SimonSchaeff/variable-frequency-drive-induction-motor/source_code/README.md

# README for Source Code

Create an empty folder for workspace of STM32 IDE
(It is not the project folder!)
