SimonSchaeff/variable-frequency-drive-induction-motor/hardware/BOM/BOM_Frequenzumrchter_Hoyer_Schaeffler_Scheel.xlsx

No. | Schaltplanbauteil | Bezeichnung | Wert | Footprint | Menge
1 | C1, C3, C7, C9, C20, C21, C23, C28, C34 |  | 100nF | C_0603_1608Metric | 9
2 | C15, C16, C17, C18, C19, C22, C24, C26 |  | 10nF | C_0603_1608Metric | 8
3 | C27, C29, C30, C31, C32, C33 |  | 220pF | C_0603_1608Metric | 6
4 | C10, C11, C12, C13, C14 | Elektrolytkondensator | LGU2W471MELC | CAPPRD1000W190D3550H5200 | 5
5 | C2, C4, C6, C8 |  | 10uF | C_1206_3216Metric | 4
6 | C5, C25 |  | 4.7 nF | C_0603_1608Metric | 2
7 | C35 |  | 330nF | C_0603_1608Metric | 1
8 | C36 |  | 1uF | C_0603_1608Metric | 1
9 | R1, R2, R3, R5, R6, R7, R8, R9, R10, R11 |  | 1k | R_0603_1608Metric | 10
10 | R28, R30, R31, R32, R35, R36, R37 |  | 100 | R_0603_1608Metric | 7
11 | R38, R39, R40, R41, R42, R43, R44 |  | 150 | R_0603_1608Metric | 7
12 | R14, R15, R16 | Shunt-Widerstand | WSLF25123L000FEA | RESC6430X48N | 3
13 | R17, R18, R19 |  | 3.9k | R_0603_1608Metric | 3
14 | R20, R22, R24 |  | 15k | R_0603_1608Metric | 3
15 | R21, R23, R25 |  | 12k | R_0603_1608Metric | 3
16 | R29, R33 |  | 10k | R_0603_1608Metric | 2
17 | R4 |  | 1 | R_0603_1608Metric | 1
18 | R12 | Leistungswiderstand 5W | EP5WS47RJ | RESAD5900W80L2500D850 | 1
19 | R13 |  | R 100k | R_0603_1608Metric | 1
20 | R26 |  | R 33k | R_0603_1608Metric | 1
21 | R27 |  | R 100 | R_0603_1608Metric | 1
22 | R34 |  | 470 | R_0603_1608Metric | 1
23 | D1, D2, D4, D5 | Gleichrichterdiode | 10A10-T | DIOAD4425W130L885D885 | 4
24 | D3 | Schutzdiode | 1N4007 | D_DO-41_SOD81_P10.16mm_Horizontal | 1
25 | D6 |  | LED | LED_0805_2012Metric | 1
26 | U1, U2, U3 | Strommess-IC | INA240A3D | SOIC-8_3.9x4.9mm_P1.27mm | 3
27 | U4 | 12V Spannungsregler | MC78M12BDTRKG | DPAK-3_ONS | 1
28 | DS1, DS2 | 7-Seg. Display | SC52-11SURKWA | SC5211SURKWA | 2
29 | IC1 | Powermodul | IM523L6AXKMA1 | IM523L6AXKMA1 | 1
30 | K1 | Vorladerelais | T9GV5L14-15 | T9GV5L1415 | 1
31 | PS1 | 15V Netzteil | IRM-10-15 | Converter_ACDC_MeanWell_IRM-10-xx_THT | 1
32 | Q1 | Bipolartransistor: | BC337 | TO-92_Inline | 1
33 | RV1 | Potentiometer | PC16SV-10IP06-103A2020-TA_PHR | PC16SV-10IP06-103A2020-TA_PHR | 1
34 | S1 | Button-Switch | TL1105YF160Q | TL1105YF160Q | 1
35 | Z1 | Zehnerdiode | 1N5352B-TP | DIOAD1910W90L670D310 | 1
36 | J1, J4 | Anschlussklemme | WAGO 2604-1103 | 26041103 | 2
37 | J7, J8 | Pinsockel | Pin Socket 61304021821 | RHDR40W97P254X254_2X20_5130X508X860P | 2
38 | J2 | Pinsockel | Conn_01x06_Socket | PinSocket_1x06_P2.54mm_Vertical | 1
39 | J3 | Banannebuchse rot | 66.9040-22 | 66904022 | 1
40 | J5 | Banannebuchse schwarz | 66.9040-21 | 66904021 | 1
41 | J6 | Lüfterstecker: | MC000034 | MC000034 | 1
42 |  | Kühlkörper | Fischer SK 68 100 SA | n/a | 1
43 |  | Lüfter | MF50101V1-1000U-G99 | n/a | 1
44 |  | Prozessor STM32 mit Eval platine | NUCLEO F103RB | n/a | 1
