SimonSchaeff/variable-frequency-drive-induction-motor/hardware/production/bom.csv

Designator | Footprint | Quantity | Value | LCSC Part #
C1, C20, C21, C23, C28, C3, C34, C7, C9 | 0603 | 9 | 100nF
C10, C11, C12, C13, C14 | CAPPRD1000W190D3550H5200 | 5 | LGU2W471MELC
C15, C16, C17, C18, C19, C22, C24, C26 | 0603 | 8 | 10nF
C2, C4, C6, C8 | 1206 | 4 | 10uF
C25 | 0603 | 1 | C 1nF
C27, C29, C30, C31, C32, C33 | 0603 | 6 | 220pF
C35 | 0603 | 1 | 330nF
C36 | 0603 | 1 | 1uF
C5 | 0603 | 1 | 4.7 nF
D1, D2, D4, D5 | DIOAD4425W130L885D885 | 4 | 10A10-T
D3 | D_DO-41_SOD81_P10.16mm_Horizontal | 1 | 1N4007
D6 | 0805 | 1 | LED
DS1, DS2 | SC5211SURKWA | 2 | SC52-11SURKWA
IC1 | IM523L6AXKMA1 | 1 | IM523L6AXKMA1
J1, J4 | 26041103 | 2 | 2604-1103
J2 | PinSocket_1x06_P2.54mm_Vertical | 1 | Conn_01x06_Socket
J3 | 66904022 | 1 | 66.9040-22
J5 | 66904021 | 1 | 66.9040-21
J6 | MC000034 | 1 | MC000034
J7, J8 | RHDR40W97P254X254_2X20_5130X508X860P | 2 | 61304021821
K1 | T9GV5L1415 | 1 | T9GV5L14-15
PS1 | Converter_ACDC_MeanWell_IRM-10-xx_THT | 1 | IRM-10-15
Q1 | TO-92_Inline | 1 | BC337
R10, R5, R6, R7, R8, R9 | 0603 | 6 | 1k
R11 | 0603 | 1 | R 1k
R12 | RESAD5900W80L2500D850 | 1 | EP5WS47RJ
R13 | 0603 | 1 | R 100k
R14, R15, R16 | RESC6430X48N | 3 | WSLF25123L000FEA
R17, R18, R19 | 0603 | 3 | 3.9k
R20, R22, R24 | 0603 | 3 | R 15k
R21, R23, R25 | 0603 | 3 | R 12k
R26 | 0603 | 1 | R 33k
R27 | 0603 | 1 | R 100
R28, R30, R31, R32, R35 | 0603 | 5 | 100
R29, R33 | 0603 | 2 | 10k
R34 | 0603 | 1 | 470R
R36, R37 | 0603 | 2 | 100R
R38, R39, R40, R41, R42, R43, R44 | 0603 | 7 | 150
RV1 | PC16SV-10IP06-103A2020-TA_PHR | 1 | 5k
S1 | TL1105YF160Q | 1 | TL1105YF160Q
U1, U2, U3 | SOIC-8_3.9x4.9mm_P1.27mm | 3 | INA240A3D
U4 | DPAK-3_ONS | 1 | MC78M12BDTRKG
Z1 | DIOAD1910W90L670D310 | 1 | 1N5352B-TP
