SimonSchaeff/variable-frequency-drive-induction-motor/hardware/3dmodel/VFD.step

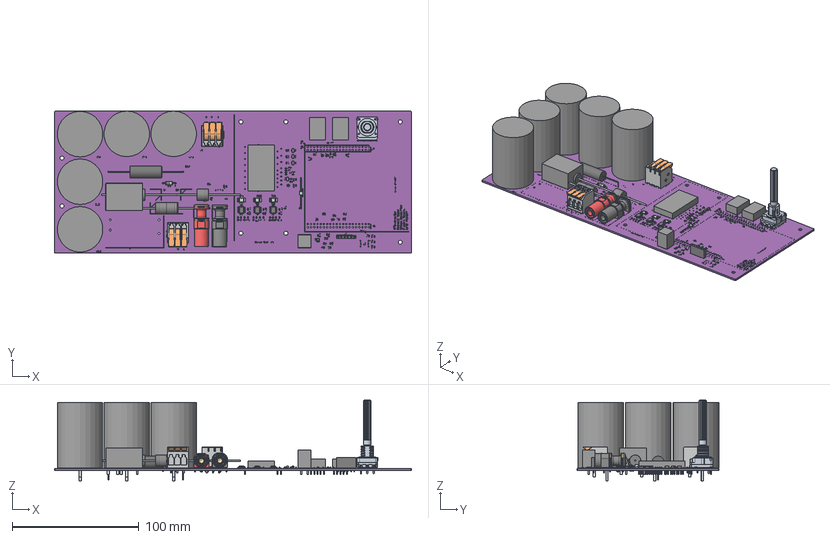
[picture p1: CAD file, 2026-10-09]
hardware/3dmodel/VFD.step
282.0 x 112.1 x 63.7 mm
C_0603_1608Metric x 27
R_0603_1608Metric x 40
SimpleBody x 6
Pin1 x 5
Pin2 x 5
SOIC-8_3.9x4.9mm_P1.27mm x 3
10A10-T x 4
Leads x 5
PinSocket_1x06_P2.54mm_Vertical
WSLF25123L000FEA x 3
C_1206_3216Metric x 4
TO-92_Inline
PC16SV-10IP06-TA-PORTARESISTENCIA
PC16SV-10IP06-TA-COLECTOR x 4
PC16SV-10IP06-TA-PORTACURSOR
PC16SV-10IP06-TA-CARCASA
PC16SV-10IP06-TA-TERMINAL APOYO_TROQUELADOS
PC16SV-10IP06-TA-EJE_Predeterminada
LED_0805_2012Metric
D_DO-41_SOD81_P10.16mm_Horizontal
vfd_silkscreen
vfd_PCB
