SimonSchaeff/variable-frequency-drive-induction-motor/project_onepager.pdf

# Projekt Spinergy

# Entwicklung eines Frequenzumrichters zur Ansteuerung eines Asynchronmotors

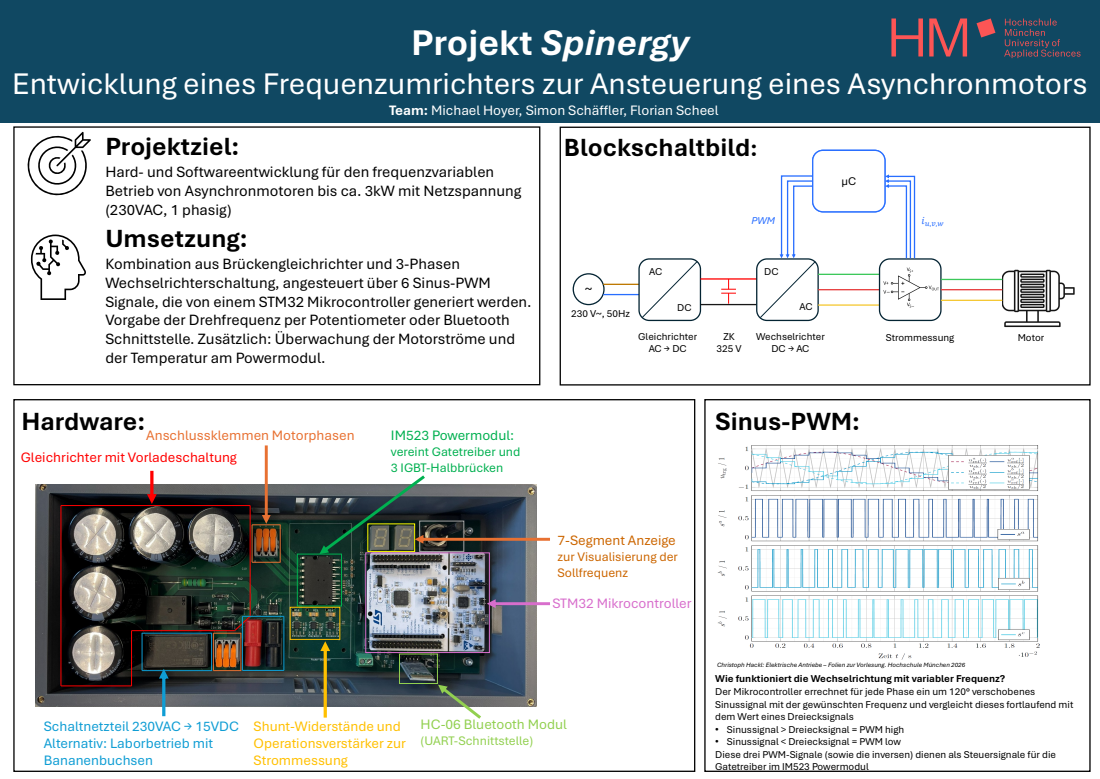
[picture p2: page 1]
Anschlussklemmen Motorphasen; Blockschaltbild:; Gleichrichter AC → DC; Strommessung; Motor; PWM; Wechselrichter DC → AC; Sinus-PWM:

Team: Michael Hoyer, Simon Schäffler, Florian Scheel

Projektziel:
Hard- und Softwareentwicklung für den frequenzvariablen
Betrieb von Asynchronmotoren bis ca. 3kW mit Netzspannung
(230VAC, 1 phasig)
Umsetzung:
Kombination aus Brückengleichrichter und 3-Phasen
Wechselrichterschaltung, angesteuert über 6 Sinus-PWM
Signale, die von einem STM32 Mikrocontroller generiert werden.
Vorgabe der Drehfrequenz per Potentiometer oder Bluetooth
Schnittstelle. Zusätzlich: Überwachung der Motorströme und
der Temperatur am Powermodul.
Hardware:

IM523 Powermodul:
vereint Gatetreiber und
3 IGBT-Halbbrücken

Gleichrichter mit Vorladeschaltung

7-Segment Anzeige
zur Visualisierung der
Sollfrequenz
STM32 Mikrocontroller

Christoph Hackl: Elektrische Antriebe – Folien zur Vorlesung. Hochschule München 2026
Wie funktioniert die Wechselrichtung mit variabler Frequenz?
Der Mikrocontroller errechnet für jede Phase ein um 120° verschobenes
Sinussignal mit der gewünschten Frequenz und vergleicht dieses fortlaufend mit
dem Wert eines Dreiecksignals
• Sinussignal > Dreiecksignal = PWM high
• Sinussignal < Dreiecksignal = PWM low
Diese drei PWM-Signale (sowie die inversen) dienen als Steuersignale für die
Gatetreiber im IM523 Powermodul

Schaltnetzteil 230VAC → 15VDC
Alternativ: Laborbetrieb mit
Bananenbuchsen

Shunt-Widerstände und
Operationsverstärker zur
Strommessung

HC-06 Bluetooth Modul
(UART-Schnittstelle)
