SimonSchaeff/variable-frequency-drive-induction-motor/hardware/vfd.kicad_pcb

## KiCad design hardware/vfd.kicad_pcb (2026-10-09)

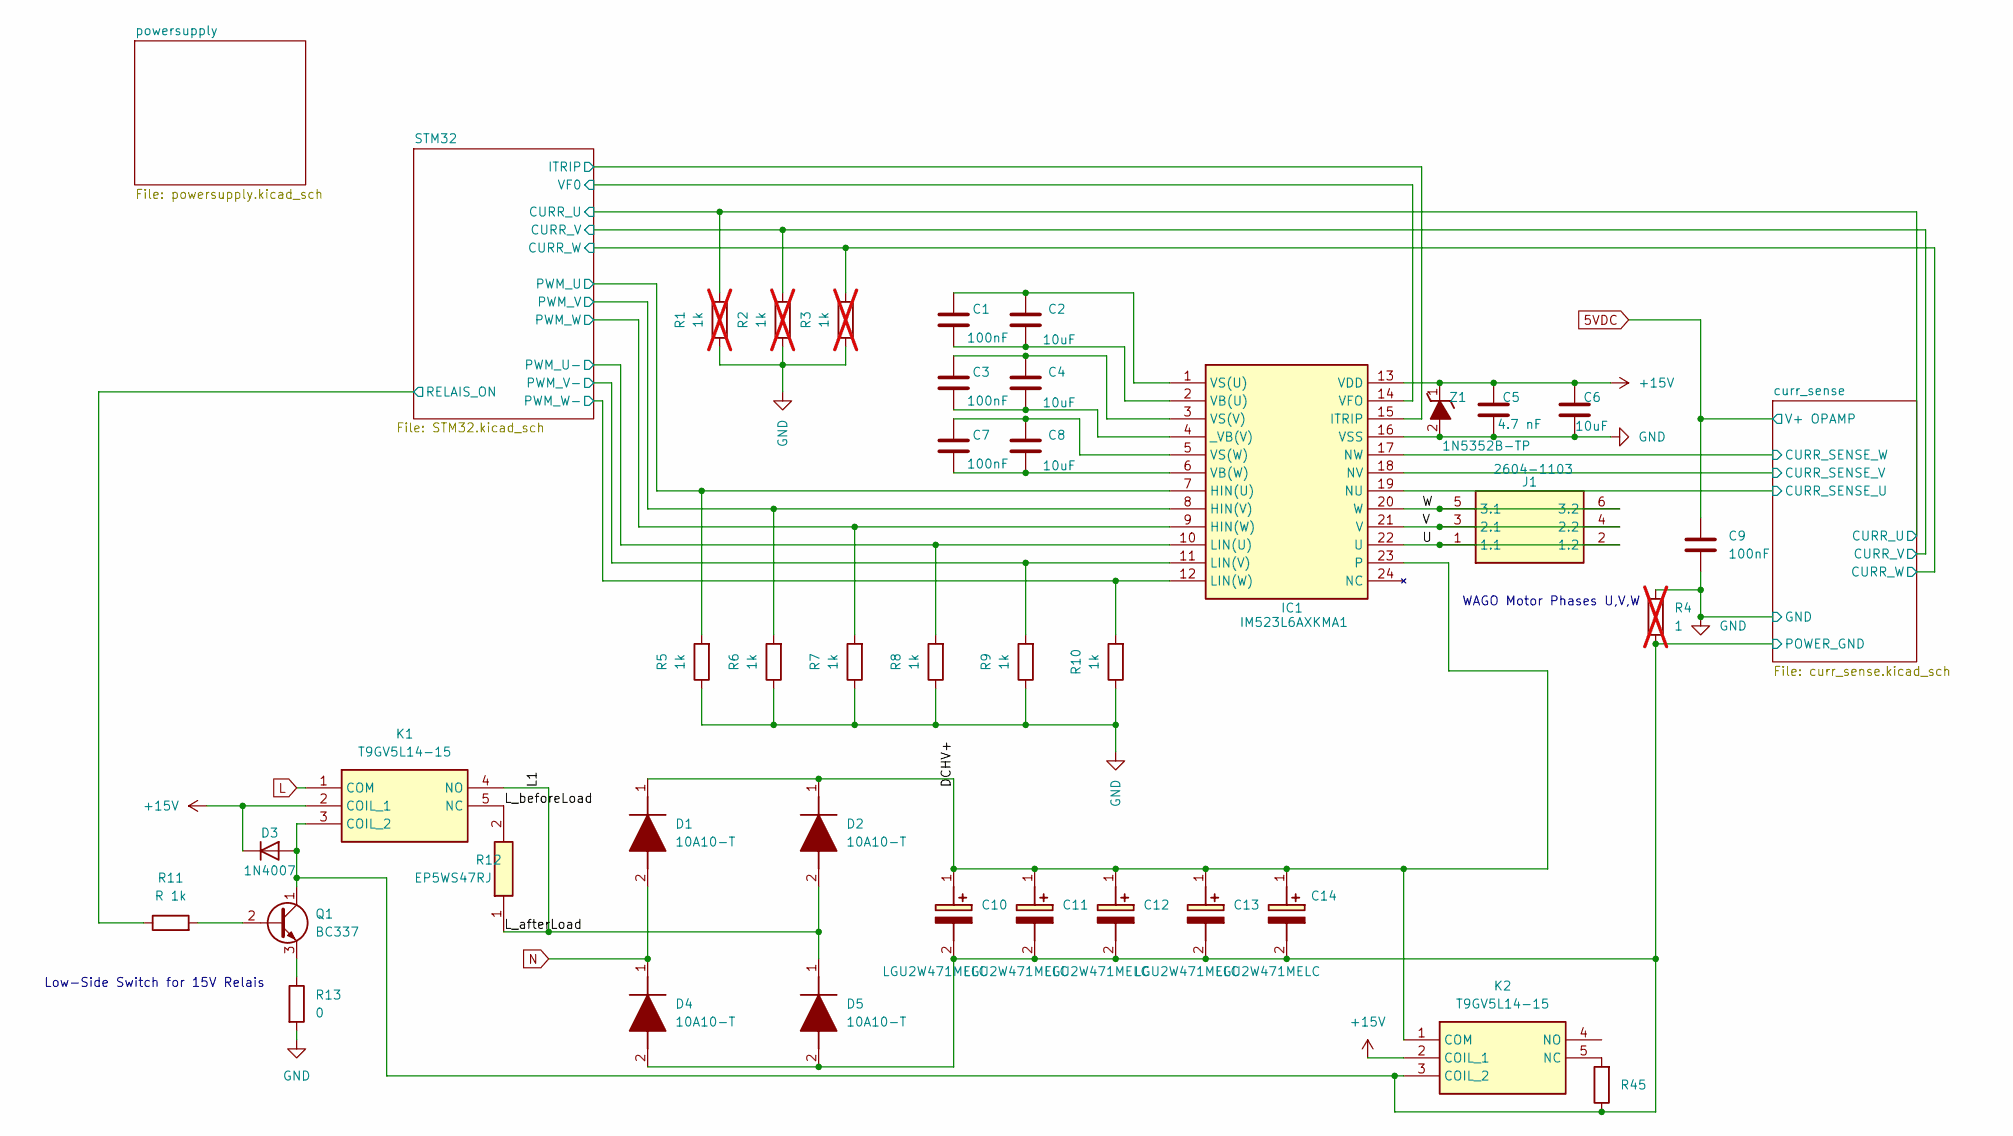
[picture p9: schematic vfd.kicad_sch, Frequenzumrichter]

Parts:
C1, C3, C7, C9: 100nF; C_0603_1608Metric
C2, C4, C6, C8: 10uF; C_1206_3216Metric
C5: 4.7 nF; C_0603_1608Metric
C10, C11, C12, C13, C14: LGU2W471MELC; CAPPRD1000W190D3550H5200; Mouser Part Number 647-LGU2W471MELC
D1, D2, D4, D5: 10A10-T; DIOAD4425W130L885D885; Mouser Part Number 583-10A10
D3: 1N4007; D_DO-41_SOD81_P10.16mm_Horizontal
IC1: IM523L6AXKMA1; Manufacturer_Part_Number IM523L6AXKMA1; Mouser Part Number 726-IM523L6AXKMA1
J1: 2604-1103; 26041103; Manufacturer_Part_Number 2604-1103
K1, K2: T9GV5L14-15; T9GV5L1415; Mouser Part Number 655-T9GV5L14-15
Q1: BC337; TO-92_Inline
R1, R2, R3: 1k; R_0603_1608Metric; not fitted
R4: 1; R_0603_1608Metric; not fitted
R5, R6, R7, R8, R9, R10: 1k; R_0603_1608Metric
R11: R 1k; R_0603_1608Metric
R12: EP5WS47RJ; RESAD5900W80L2500D850; Manufacturer_Part_Number EP5WS47RJ; Mouser Part Number 279-EP5WS47RJ
R13: 0; R_0603_1608Metric
R45: R_0603_1608Metric
Z1: 1N5352B-TP; DIOAD1910W90L670D310; Mouser Part Number 833-1N5352B-TP

Connections:
5VDC: C9.1; also elsewhere on the board
+15V: C5.1, C6.1, D3.1 (K), IC1.13 (VDD), K1.2 (COIL_1), K2.2 (COIL_1), Z1.1 (K); also elsewhere on the board
/DCHV+: C10.1 (+), C11.1 (+), C12.1 (+), C13.1 (+), C14.1 (+), D1.1 (K), D2.1 (K), IC1.23, K2.1 (COM)
/L1: D2.2 (A), D5.1 (K), K1.4 (NO), R12.1
/L_beforeLoad: K1.5 (NC), R12.2
/STM32/CURR_U: R1.2; also elsewhere on the board
/STM32/CURR_V: R2.2; also elsewhere on the board
/STM32/CURR_W: R3.2; also elsewhere on the board
/STM32/ITRIP: IC1.15 (ITRIP); also elsewhere on the board
/STM32/PWM_U: IC1.7 (HIN(U)), R5.2; also elsewhere on the board
/STM32/PWM_U-: IC1.10 (LIN(U)), R8.2; also elsewhere on the board
/STM32/PWM_V: IC1.8 (HIN(V)), R6.2; also elsewhere on the board
/STM32/PWM_V-: IC1.11 (LIN(V)), R9.2; also elsewhere on the board
/STM32/PWM_W: IC1.9 (HIN(W)), R7.2; also elsewhere on the board
/STM32/PWM_W-: IC1.12 (LIN(W)), R10.2; also elsewhere on the board
/STM32/RELAIS_ON: R11.1; also elsewhere on the board
/STM32/VF0: IC1.14 (VFO); also elsewhere on the board
/U: IC1.22 (U), J1.1 (1.1), J1.2 (1.2)
/V: IC1.21 (V), J1.3 (2.1), J1.4 (2.2)
/W: IC1.20 (W), J1.5 (3.1), J1.6 (3.2)
/curr_sense/CURR_SENSE_U: IC1.19 (NU); also elsewhere on the board
/curr_sense/CURR_SENSE_V: IC1.18 (NV); also elsewhere on the board
/curr_sense/CURR_SENSE_W: IC1.17 (NW); also elsewhere on the board
GND: C5.2, C6.2, C9.2, IC1.16 (VSS), R1.1, R2.1, R3.1, R4.2, R5.1, R6.1, R7.1, R8.1, R9.1, R10.1, R13.2, Z1.2 (A); also elsewhere on the board
L: K1.1 (COM); also elsewhere on the board
N: D1.2 (A), D4.1 (K); also elsewhere on the board
unnamed: C1.2, C2.2, IC1.2 (VB(U))
unnamed: C7.2, C8.2, IC1.6 (VB(W))
unnamed: C1.1, C2.1, IC1.1 (VS(U))
unnamed: C3.1, C4.1, IC1.3 (VS(V))
unnamed: C7.1, C8.1, IC1.5 (VS(W))
unnamed: C3.2, C4.2, IC1.4 (_VB(V))
unnamed: K2.5 (NC), R45.2
unnamed: Q1.2 (B), R11.2
unnamed: Q1.3 (E), R13.1

Notes on the sheet:
WAGO Motor Phases U,V,W
Low-Side Switch for 15V Relais

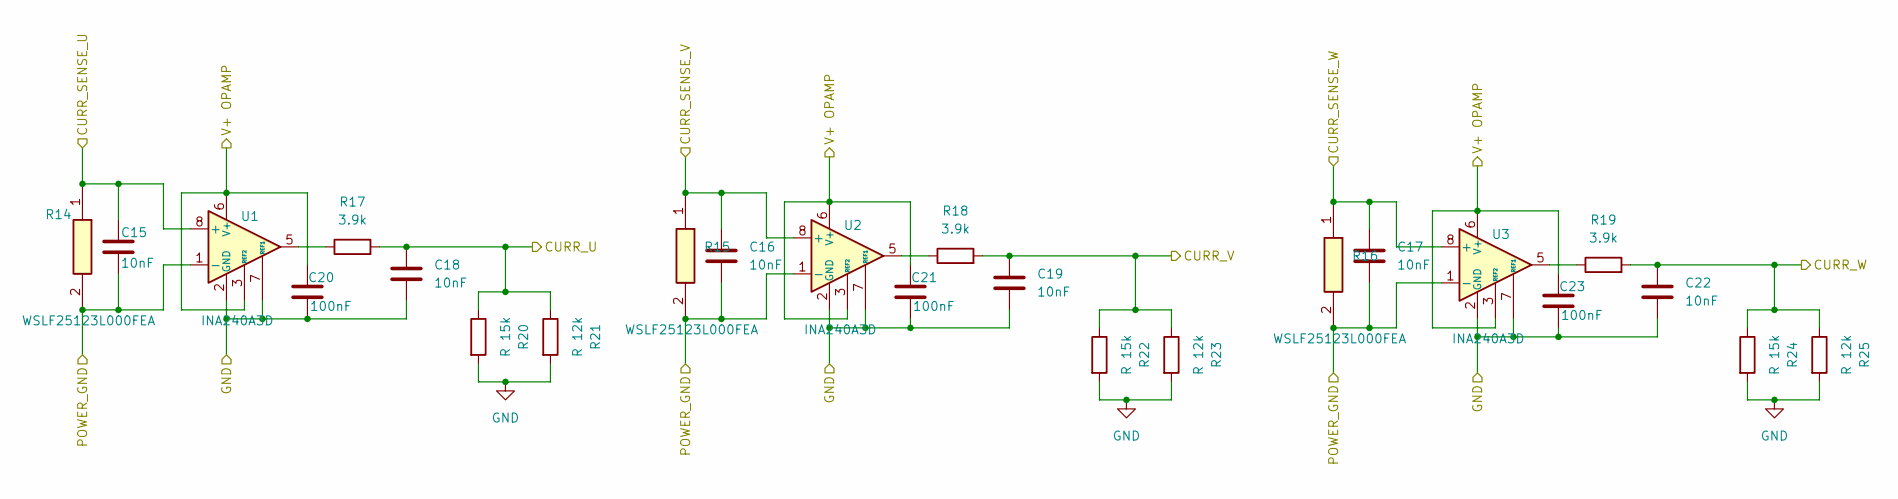
[picture p10: schematic curr_sense.kicad_sch, Current Sensors]

Parts:
C15, C16, C17, C18, C19, C22: 10nF; C_0603_1608Metric
C20, C21, C23: 100nF; C_0603_1608Metric
R14, R15, R16: WSLF25123L000FEA; RESC6430X48N; Mouser Part Number 71-WSLF25123L000FEA
R17, R18, R19: 3.9k; R_0603_1608Metric
R20, R22, R24: R 15k; R_0603_1608Metric
R21, R23, R25: R 12k; R_0603_1608Metric
U1, U2, U3: INA240A3D; SOIC-8_3.9x4.9mm_P1.27mm

Connections:
5VDC: C20.1, C21.1, C23.1, U1.3 (REF2), U1.6 (V+), U2.3 (REF2), U2.6 (V+), U3.3 (REF2), U3.6 (V+); also elsewhere on the board
/STM32/CURR_U: C18.1, R17.2, R20.1, R21.1; also elsewhere on the board
/STM32/CURR_V: C19.1, R18.2, R22.1, R23.1; also elsewhere on the board
/STM32/CURR_W: C22.1, R19.2, R24.1, R25.1; also elsewhere on the board
/curr_sense/CURR_SENSE_U: C15.1, R14.1, U1.8 (+); also elsewhere on the board
/curr_sense/CURR_SENSE_V: C16.1, R15.1, U2.8 (+); also elsewhere on the board
/curr_sense/CURR_SENSE_W: C17.1, R16.1, U3.8 (+); also elsewhere on the board
GND: C18.2, C19.2, C20.2, C21.2, C22.2, C23.2, R20.2, R21.2, R22.2, R23.2, R24.2, R25.2, U1.2 (GND), U1.4 (GND), U1.7 (REF1), U2.2 (GND), U2.4 (GND), U2.7 (REF1), U3.2 (GND), U3.4 (GND), U3.7 (REF1); also elsewhere on the board
unnamed: R17.1, U1.5
unnamed: R18.1, U2.5
unnamed: R19.1, U3.5

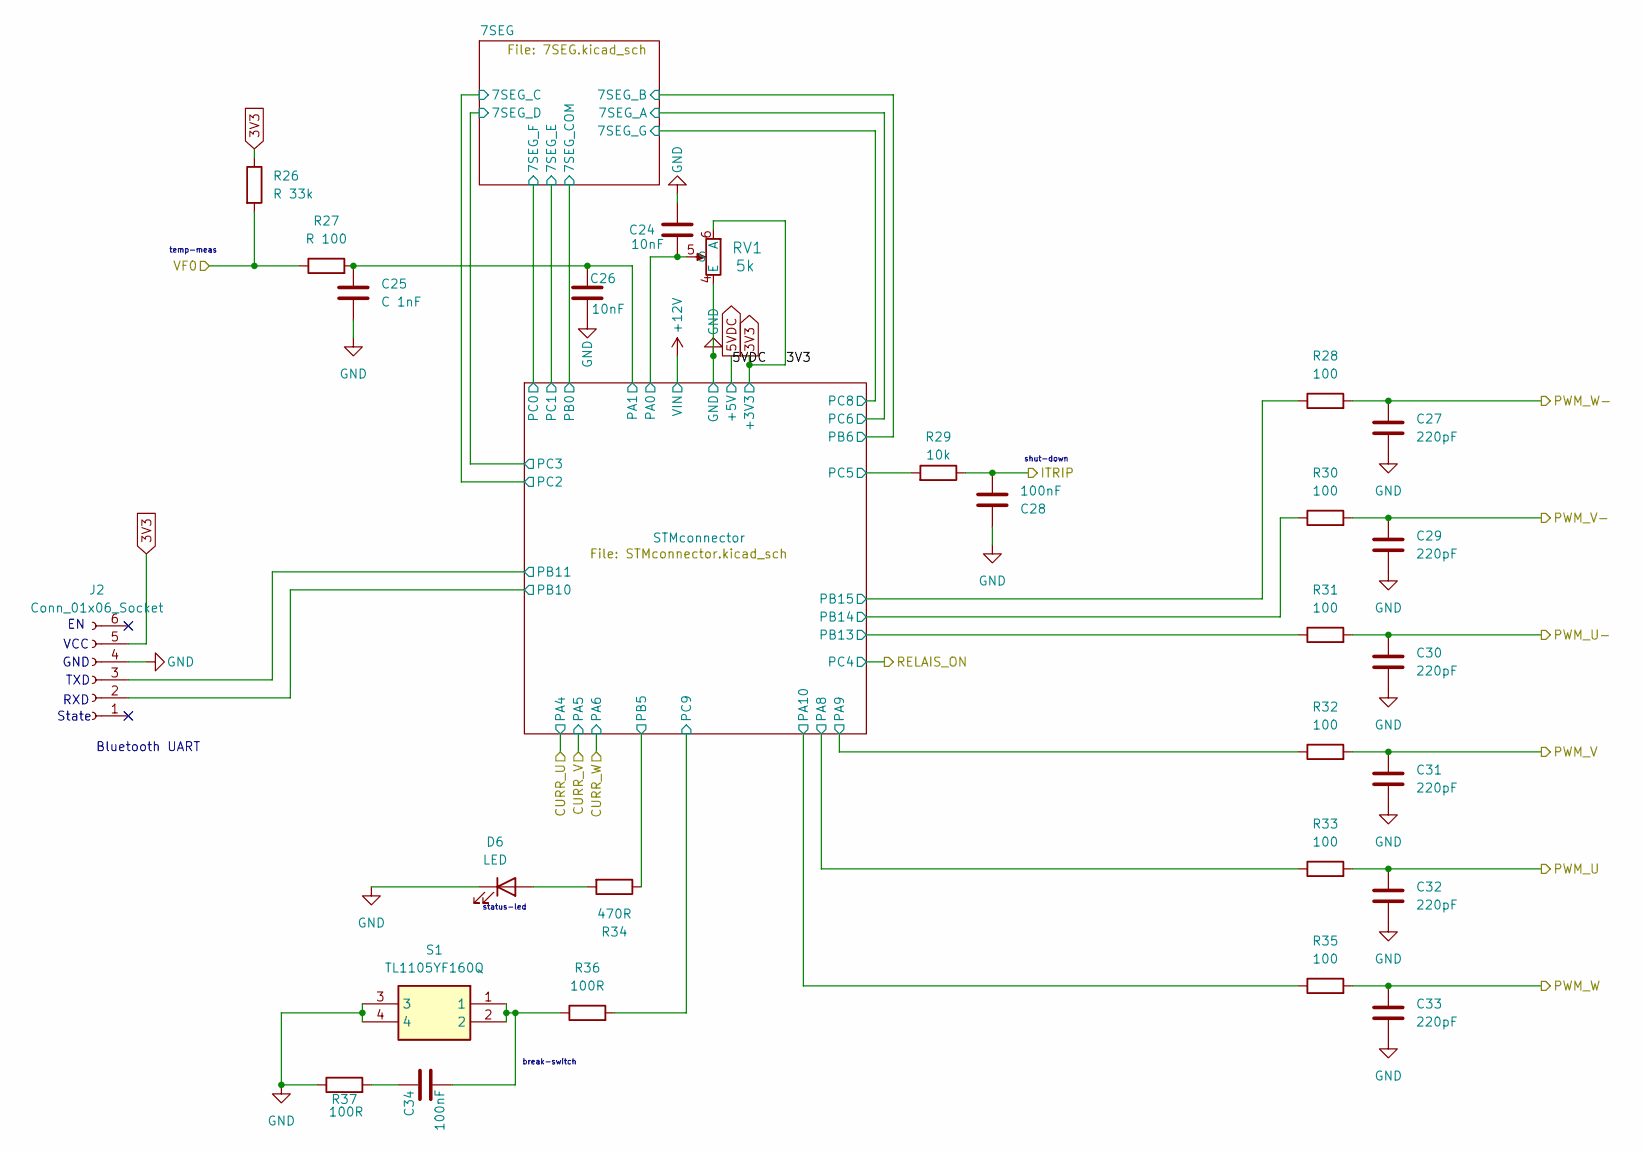
[picture p11: schematic STM32.kicad_sch, STM32 Schematic]

Parts:
C24, C26: 10nF; C_0603_1608Metric
C25: C 1nF; C_0603_1608Metric
C27, C29, C30, C31, C32, C33: 220pF; C_0603_1608Metric
C28, C34: 100nF; C_0603_1608Metric
D6: LED; LED_0805_2012Metric
J2: Conn_01x06_Socket; PinSocket_1x06_P2.54mm_Vertical
R26: R 33k; R_0603_1608Metric
R27: R 100; R_0603_1608Metric
R28, R30, R31, R32, R33, R35: 100; R_0603_1608Metric
R29: 10k; R_0603_1608Metric
R34: 470R; R_0603_1608Metric
R36, R37: 100R; R_0603_1608Metric
RV1: 5k; PC16SV-10IP06-103A2020-TA_PHR
S1: TL1105YF160Q; Mouser Part Number 612-TL1105YF160Q

Connections:
3V3: J2.5, R26.1, RV1.6 (A); also elsewhere on the board
/STM32/ITRIP: C28.2, R29.1; also elsewhere on the board
/STM32/PWM_U: C32.1, R33.2; also elsewhere on the board
/STM32/PWM_U-: C30.1, R31.2; also elsewhere on the board
/STM32/PWM_V: C31.1, R32.2; also elsewhere on the board
/STM32/PWM_V-: C29.1, R30.2; also elsewhere on the board
/STM32/PWM_W: C33.1, R35.2; also elsewhere on the board
/STM32/PWM_W-: C27.1, R28.2; also elsewhere on the board
/STM32/STMconnector/PA0: C24.1, RV1.5 (S); also elsewhere on the board
/STM32/STMconnector/PA1: C25.2, C26.1, R27.2; also elsewhere on the board
/STM32/STMconnector/PA8: R33.1; also elsewhere on the board
/STM32/STMconnector/PA9: R32.1; also elsewhere on the board
/STM32/STMconnector/PA10: R35.1; also elsewhere on the board
/STM32/STMconnector/PB5: R34.1; also elsewhere on the board
/STM32/STMconnector/PB10: J2.2; also elsewhere on the board
/STM32/STMconnector/PB11: J2.3; also elsewhere on the board
/STM32/STMconnector/PB13: R31.1; also elsewhere on the board
/STM32/STMconnector/PB14: R30.1; also elsewhere on the board
/STM32/STMconnector/PB15: R28.1; also elsewhere on the board
/STM32/STMconnector/PC5: R29.2; also elsewhere on the board
/STM32/STMconnector/PC9: R36.2; also elsewhere on the board
/STM32/VF0: R26.2, R27.1; also elsewhere on the board
GND: C24.2, C25.1, C26.2, C27.2, C28.1, C29.2, C30.2, C31.2, C32.2, C33.2, D6.1 (K), J2.4, R37.1, RV1.4 (E), S1.3, S1.4; also elsewhere on the board
unnamed: C34.1, R37.2
unnamed: C34.2, R36.1, S1.1, S1.2
unnamed: D6.2 (A), R34.2

Notes on the sheet:
Bluetooth UART
shut-down
RXD
break-switch
GND
temp-meas
State
VCC
status-led
TXD

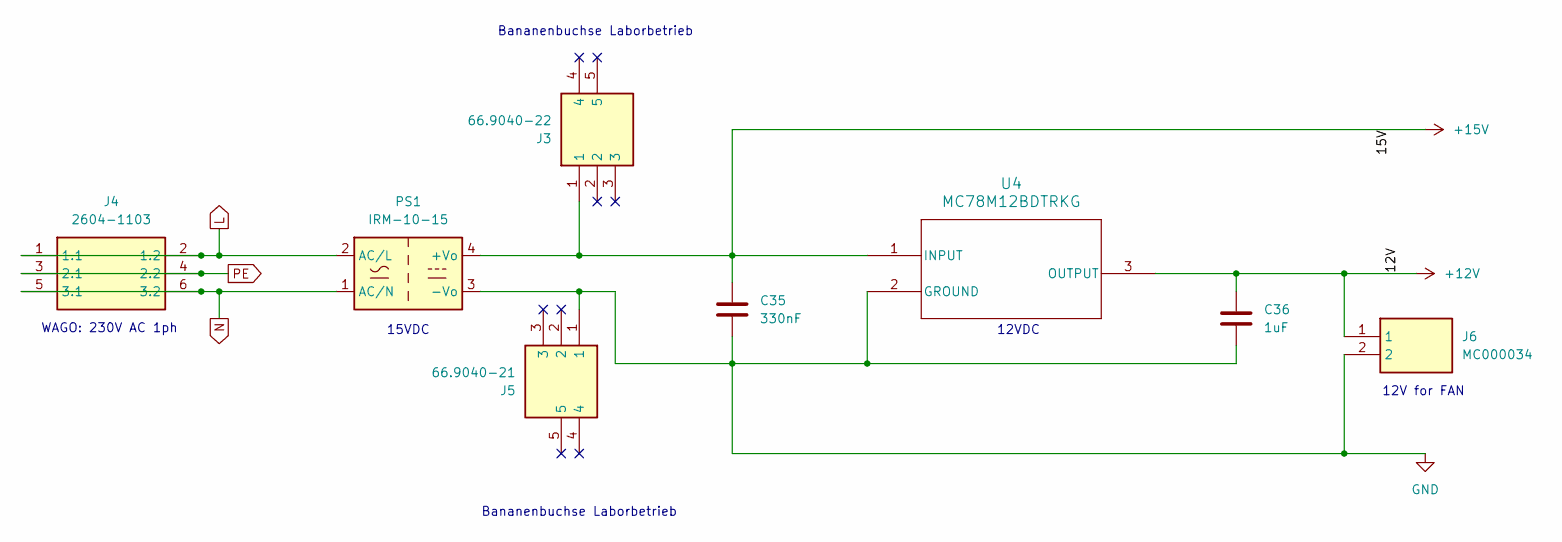
[picture p12: schematic powersupply.kicad_sch, Powersuppy]

Parts:
C35: 330nF; C_0603_1608Metric
C36: 1uF; C_0603_1608Metric
J3: 66.9040-22; 66904022; Manufacturer_Part_Number 66.9040-22
J4: 2604-1103; 26041103; Manufacturer_Part_Number 2604-1103
J5: 66.9040-21; 66904021; Manufacturer_Part_Number 66.9040-21
J6: MC000034; Manufacturer_Part_Number MC000034
PS1: IRM-10-15; Converter_ACDC_MeanWell_IRM-10-xx_THT
U4: MC78M12BDTRKG; DPAK-3_ONS

Connections:
+12V: C36.1, J6.1, U4.3 (OUTPUT); also elsewhere on the board
+15V: C35.1, J3.1 (1_1), PS1.4 (+Vo), U4.1 (INPUT); also elsewhere on the board
GND: C35.2, C36.2, J5.1 (1_1), J6.2, PS1.3 (-Vo), U4.2 (GROUND); also elsewhere on the board
L: J4.1 (1.1), J4.2 (1.2), PS1.2 (AC/L); also elsewhere on the board
N: J4.5 (3.1), J4.6 (3.2), PS1.1 (AC/N); also elsewhere on the board
PE: J4.3 (2.1), J4.4 (2.2)

Notes on the sheet:
WAGO: 230V AC 1ph
12VDC
Bananenbuchse Laborbetrieb
15VDC
12V for FAN

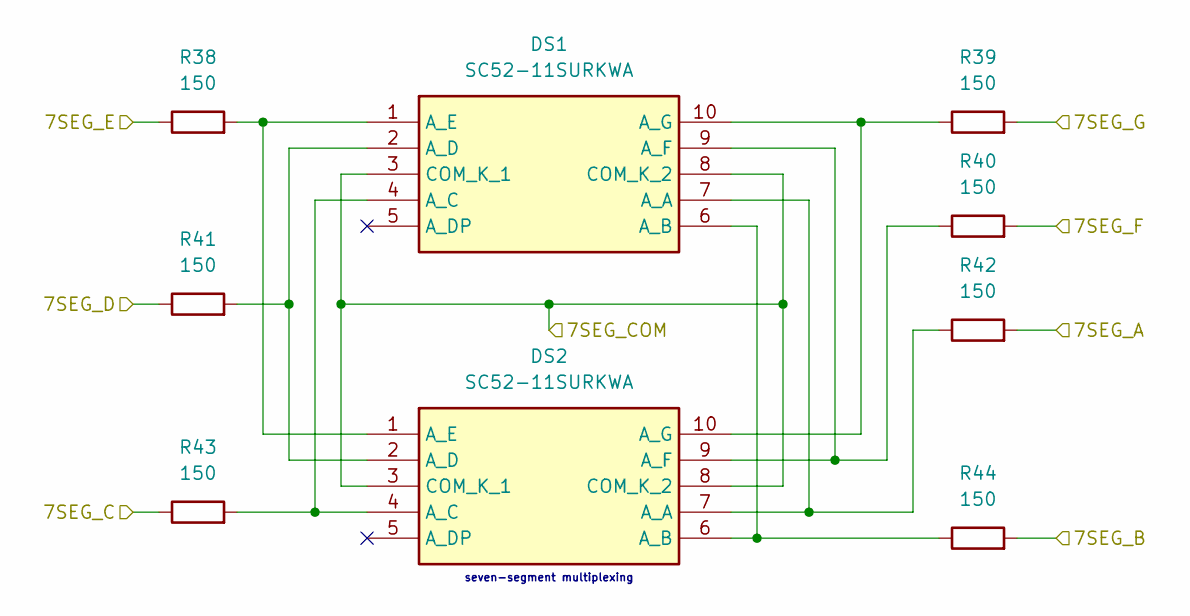
[picture p13: schematic 7SEG.kicad_sch, 7SEGMENTDISPLAYS]

Parts:
DS1, DS2: SC52-11SURKWA; SC5211SURKWA; Manufacturer_Part_Number SC52-11SURKWA; Mouser Part Number 604-SC5211SURKWA
R38, R39, R40, R41, R42, R43, R44: 150; R_0603_1608Metric

Connections:
/STM32/7SEG/7SEG_A: R42.2; also elsewhere on the board
/STM32/7SEG/7SEG_B: R44.2; also elsewhere on the board
/STM32/7SEG/7SEG_C: R43.1; also elsewhere on the board
/STM32/7SEG/7SEG_COM: DS1.3 (COM_K_1), DS1.8 (COM_K_2), DS2.3 (COM_K_1), DS2.8 (COM_K_2); also elsewhere on the board
/STM32/7SEG/7SEG_D: R41.1; also elsewhere on the board
/STM32/7SEG/7SEG_E: R38.1; also elsewhere on the board
/STM32/7SEG/7SEG_F: R40.2; also elsewhere on the board
/STM32/7SEG/7SEG_G: R39.2; also elsewhere on the board
unnamed: DS1.7 (A_A), DS2.7 (A_A), R42.1
unnamed: DS1.6 (A_B), DS2.6 (A_B), R44.1
unnamed: DS1.4 (A_C), DS2.4 (A_C), R43.2
unnamed: DS1.2 (A_D), DS2.2 (A_D), R41.2
unnamed: DS1.1 (A_E), DS2.1 (A_E), R38.2
unnamed: DS1.9 (A_F), DS2.9 (A_F), R40.1
unnamed: DS1.10 (A_G), DS2.10 (A_G), R39.1

Notes on the sheet:
seven-segment multiplexing

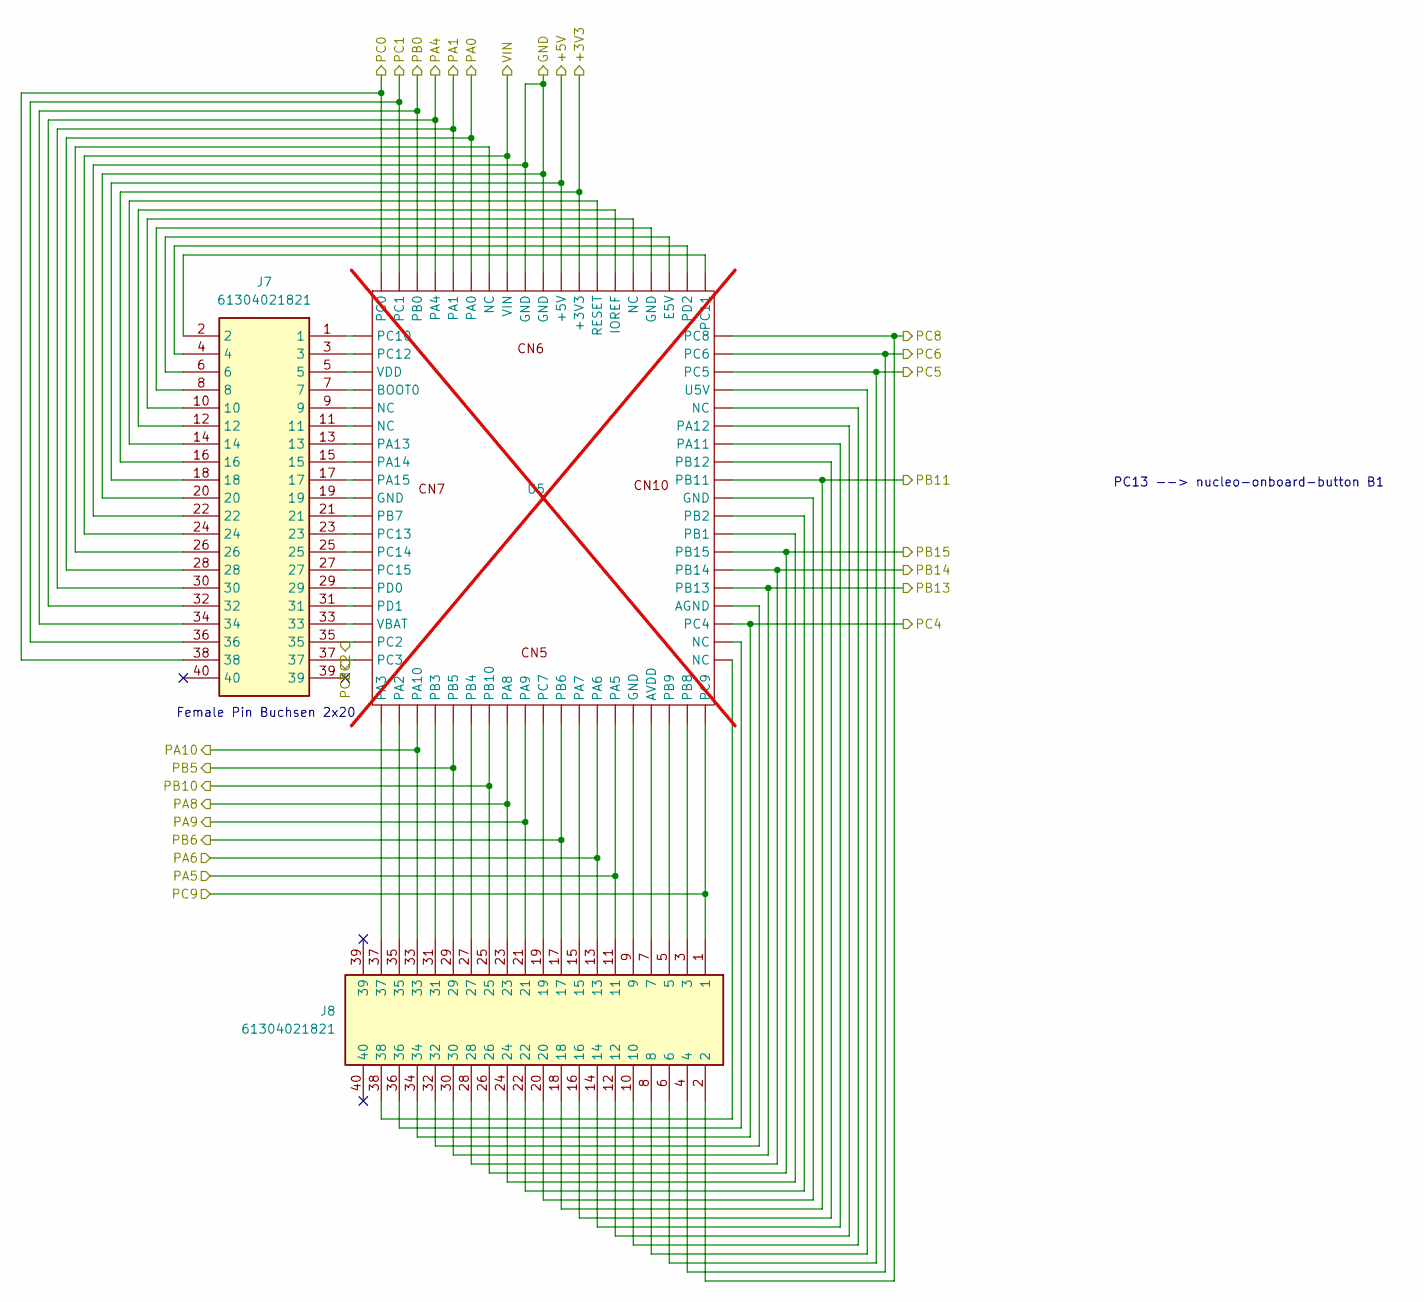
[picture p14: schematic STMconnector.kicad_sch, STM Female Pin Socket Connector]

Parts:
J7, J8: 61304021821; RHDR40W97P254X254_2X20_5130X508X860P; Manufacturer_Part_Number 61304021821; Mouser Part Number 710-61304021821
U5: not fitted

Connections:
3V3: J7.16, U5.; also elsewhere on the board
5VDC: J7.18, U5.; also elsewhere on the board
+12V: J7.24, U5.; also elsewhere on the board
/STM32/7SEG/7SEG_A: J8.4, U5.; also elsewhere on the board
/STM32/7SEG/7SEG_B: J8.17, U5.; also elsewhere on the board
/STM32/7SEG/7SEG_C: J7.35, U5.; also elsewhere on the board
/STM32/7SEG/7SEG_COM: J7.34, U5.; also elsewhere on the board
/STM32/7SEG/7SEG_D: J7.37, U5.; also elsewhere on the board
/STM32/7SEG/7SEG_E: J7.36, U5.; also elsewhere on the board
/STM32/7SEG/7SEG_F: J7.38, U5.; also elsewhere on the board
/STM32/7SEG/7SEG_G: J8.2, U5.; also elsewhere on the board
/STM32/CURR_U: J7.32, U5.; also elsewhere on the board
/STM32/CURR_V: J8.11, U5.; also elsewhere on the board
/STM32/CURR_W: J8.13, U5.; also elsewhere on the board
/STM32/RELAIS_ON: J8.34, U5.; also elsewhere on the board
/STM32/STMconnector/PA0: J7.28, U5.; also elsewhere on the board
/STM32/STMconnector/PA1: J7.30, U5.; also elsewhere on the board
/STM32/STMconnector/PA8: J8.23, U5.; also elsewhere on the board
/STM32/STMconnector/PA9: J8.21, U5.; also elsewhere on the board
/STM32/STMconnector/PA10: J8.33, U5.; also elsewhere on the board
/STM32/STMconnector/PB5: J8.29, U5.; also elsewhere on the board
/STM32/STMconnector/PB10: J8.25, U5.; also elsewhere on the board
/STM32/STMconnector/PB11: J8.18, U5.; also elsewhere on the board
/STM32/STMconnector/PB13: J8.30, U5.; also elsewhere on the board
/STM32/STMconnector/PB14: J8.28, U5.; also elsewhere on the board
/STM32/STMconnector/PB15: J8.26, U5.; also elsewhere on the board
/STM32/STMconnector/PC5: J8.6, U5.; also elsewhere on the board
/STM32/STMconnector/PC9: J8.1, U5.; also elsewhere on the board
GND: J7.20, J7.22, U5.; also elsewhere on the board
unnamed: J7.1, U5.
unnamed: J7.2, U5.
unnamed: J7.3, U5.
unnamed: J7.4, U5.
unnamed: J7.5, U5.
unnamed: J7.6, U5.
unnamed: J7.7, U5.
unnamed: J7.8, U5.
unnamed: J7.9, U5.
unnamed: J7.10, U5.
unnamed: J7.11, U5.
unnamed: J7.12, U5.
unnamed: J7.13, U5.
unnamed: J7.14, U5.
unnamed: J7.15, U5.
unnamed: J7.17, U5.
unnamed: J7.19, U5.
unnamed: J7.21, U5.
unnamed: J7.23, U5.
unnamed: J7.25, U5.
unnamed: J7.26, U5.
unnamed: J7.27, U5.
unnamed: J7.29, U5.
unnamed: J7.31, U5.
unnamed: J7.33, U5.
unnamed: J8.3, U5.
unnamed: J8.5, U5.
unnamed: J8.7, U5.
unnamed: J8.8, U5.
unnamed: J8.9, U5.
unnamed: J8.10, U5.
unnamed: J8.12, U5.
unnamed: J8.14, U5.
unnamed: J8.15, U5.
unnamed: J8.16, U5.
unnamed: J8.19, U5.
unnamed: J8.20, U5.
unnamed: J8.22, U5.
unnamed: J8.24, U5.
unnamed: J8.27, U5.
unnamed: J8.31, U5.
unnamed: J8.32, U5.
unnamed: J8.35, U5.
unnamed: J8.36, U5.
unnamed: J8.37, U5.
unnamed: J8.38, U5.

Notes on the sheet:
PC13 --> nucleo-onboard-button B1
Female Pin Buchsen 2x20

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
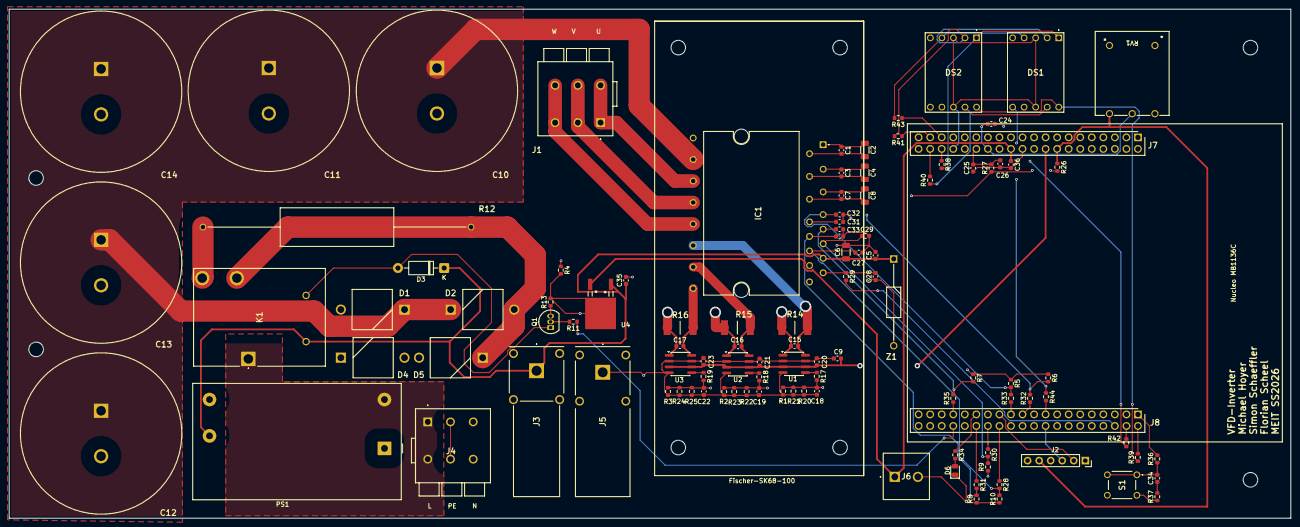
[picture p15: board vfd.kicad_pcb from above]

Board: 4 copper layers, 282.0 x 112.0 mm, 107 parts (0 on the bottom side), 73 nets.
