SimonSchaeff/variable-frequency-drive-induction-motor/source_code/Core/Inc/sevSegFunc.h

/*
 * sevSegFunc.h
 *
 *  Project:    Hochschule Muenchen
 *  Created on: 2026-04-01
 *  Author:     Simon Schäffler
 *
 */

#ifndef INC_SEVSEGFUNC_H_
#define INC_SEVSEGFUNC_H_

void sevSegInit(void);
void sevSegDecOut(int value);
void sevSegHexOut(int value);
void sevSegTask(void);

#endif /* INC_SEVSEGFUNC_H_ */
