SimonSchaeff/variable-frequency-drive-induction-motor/(notices)

Notices in the files:
source_code/Core/Inc/main.h:
Copyright (c) 2023 STMicroelectronics.
All rights reserved.
This software is licensed under terms that can be found in the LICENSE file
